nanochord/h-energosmart/docs/hajdu_energo_smart.pptx

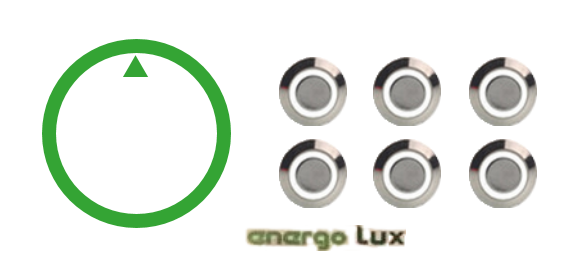
[picture p4: figure]

VCC

WCU
Power Supply
+5V
+12V

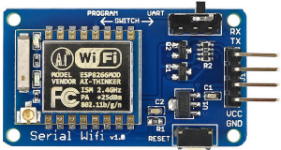
[picture p5: figure]

WiFi

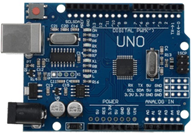
[picture p6: figure]

VCC

UART

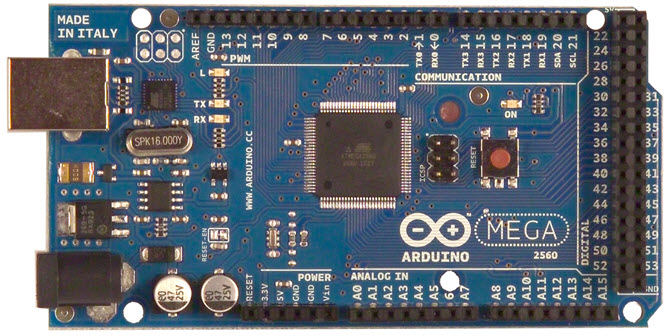
[picture p7: figure]
Képtalálat a következ&odblac;re: „arduino mega2560”

Digital Input

DOUT LED Control

I2C

UART

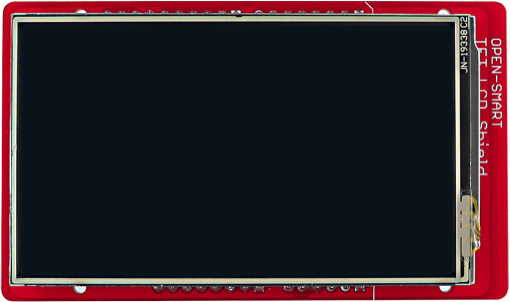
[picture p8: figure]

8-BIT BUS

HAJDU
Electromechanical Unit

Relay Contacts

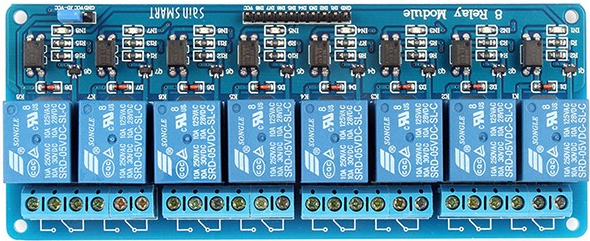
[picture p9: figure]

DOUT
Relay control

DOUT Relay control

TFT LCD

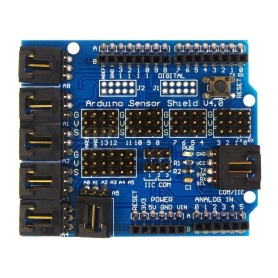
[picture p10: figure]
Képtalálat a következ&odblac;re: „arduino sensor shield”

Level control
and protection
unit

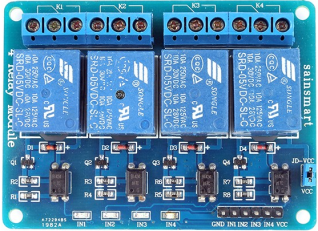
[picture p11: figure]

Digital & Analog Input

MP3

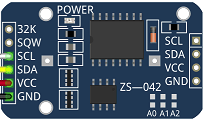
[picture p12: figure]

RTC

HAJDU Energo Smart
Block diagram
2017.6.1

## Slide 2

WMU
Motors
Radiators
Actuators
Sensors

HAJDU Energo Smart
Wiring Scheme
2017.6.1

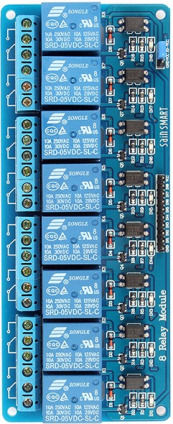
[picture p13: figure]

WCU
MEGA 2560
WIFI (ESP8266)
RTC (DS3231)
MP3 DFPlayer

+VCC
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
+VCC
B9
B10
B11
B12
GND

JP10

X4

SCOM
T36
T55
T85
WL1
WL2
WL3

X3

JP11

ROT1
ROT2
ROT3
PB1
PB2
PB3
PB4
LED1
LED2
LED3
LED4
GND

JP8

+M5V
PULSE
GND

FLOW
RATE

JP14

+12V
+5V
DOOR_LOCK
T124FUSE
CURR_OUT
MAIN SW
GND

JP13

JP9

SDA
SCL
+12V
GND

POWER BOARD
Power Supply +5V, +12V
U-Detectors 1, 2
Main SW Relay 1, 2
Current Sensor

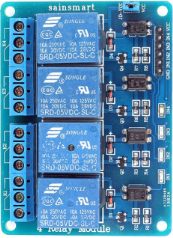
[picture p14: figure]

DISPLAY
Arduino UNO driven

+5V
GND

JP5

+5V
GND

JP6

+12V
+5V
DOOR_LOCK
T124FUSE
CURR_OUT
MAIN SW
GND

JP4

JP3

DOOR_LOCK
T124FUSE

AC OUT

KEYPAD
Buttons and LEDs

U-DETECTOR LINES

JP2

AC IN

JP1

WMU POWER LINE
~240VAC

~240VAC
