nanochord/h-energosmart/docs/10-allasu_10-polusu_valasztokapcs.jpg

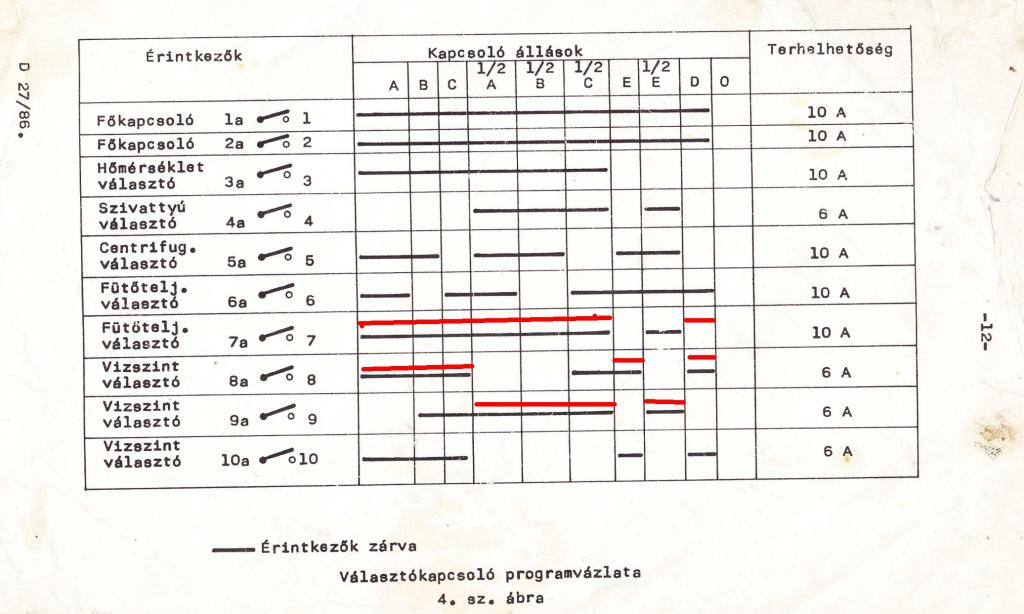
docs/10-allasu_10-polusu_valasztokapcs.jpg
