nanochord/h-energosmart/docs/aramutas_rajz_en_thermal.jpg

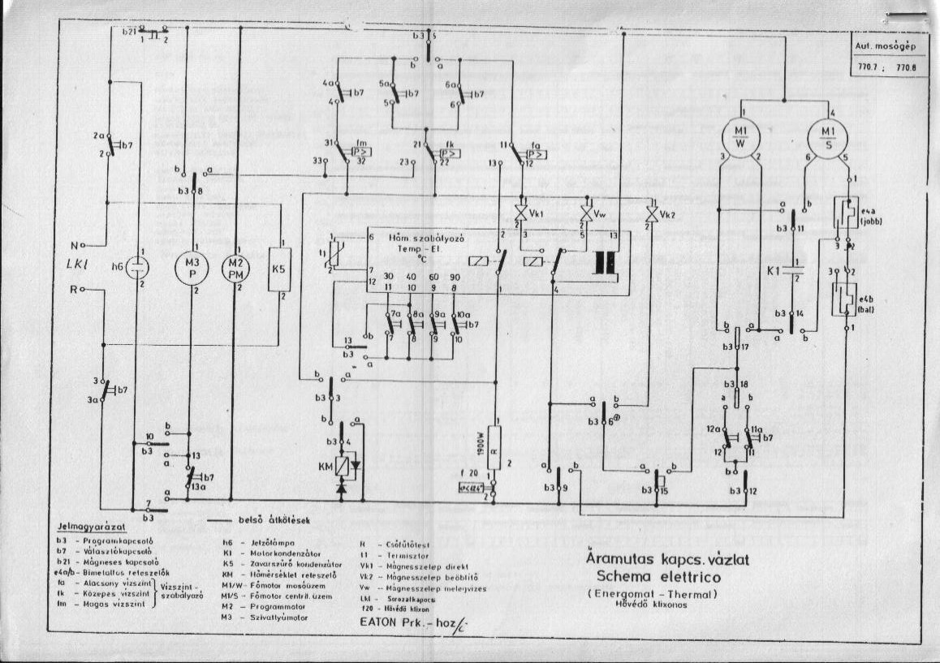
docs/aramutas_rajz_en_thermal.jpg
