nanochord/h-energosmart/docs/en-750-1.jpg

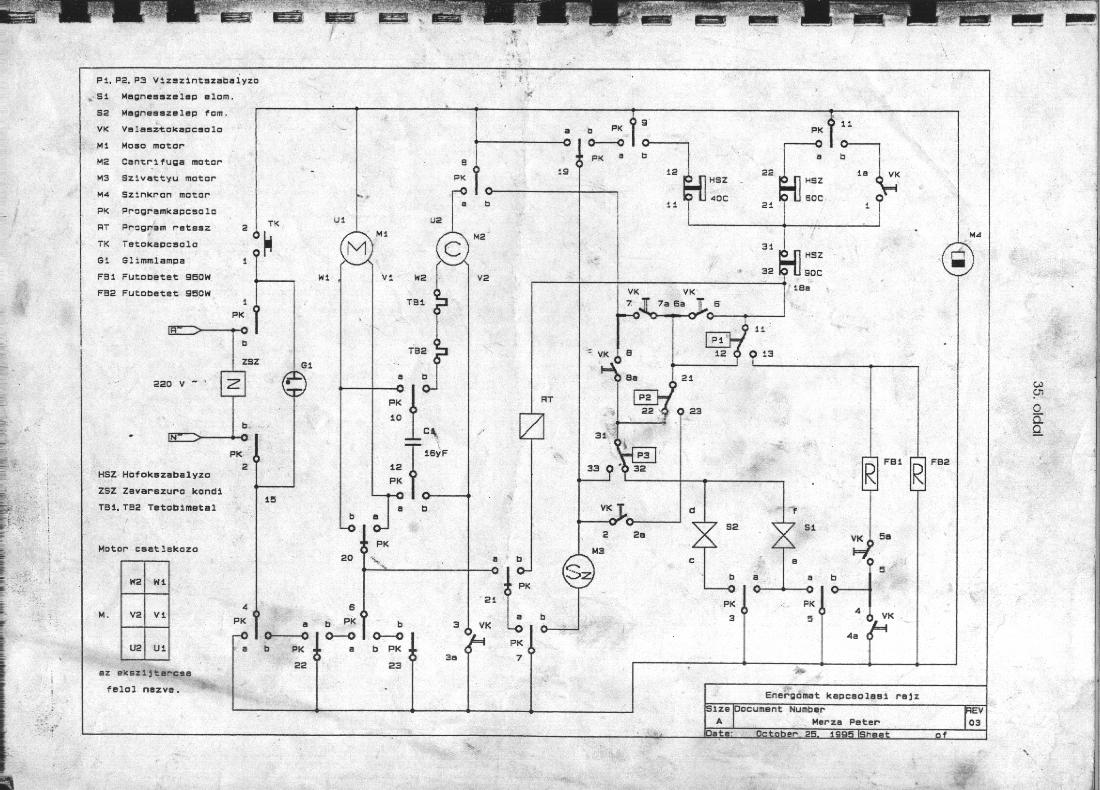
docs/en-750-1.jpg
