nanochord/h-energosmart/docs/en_750_4.jpg

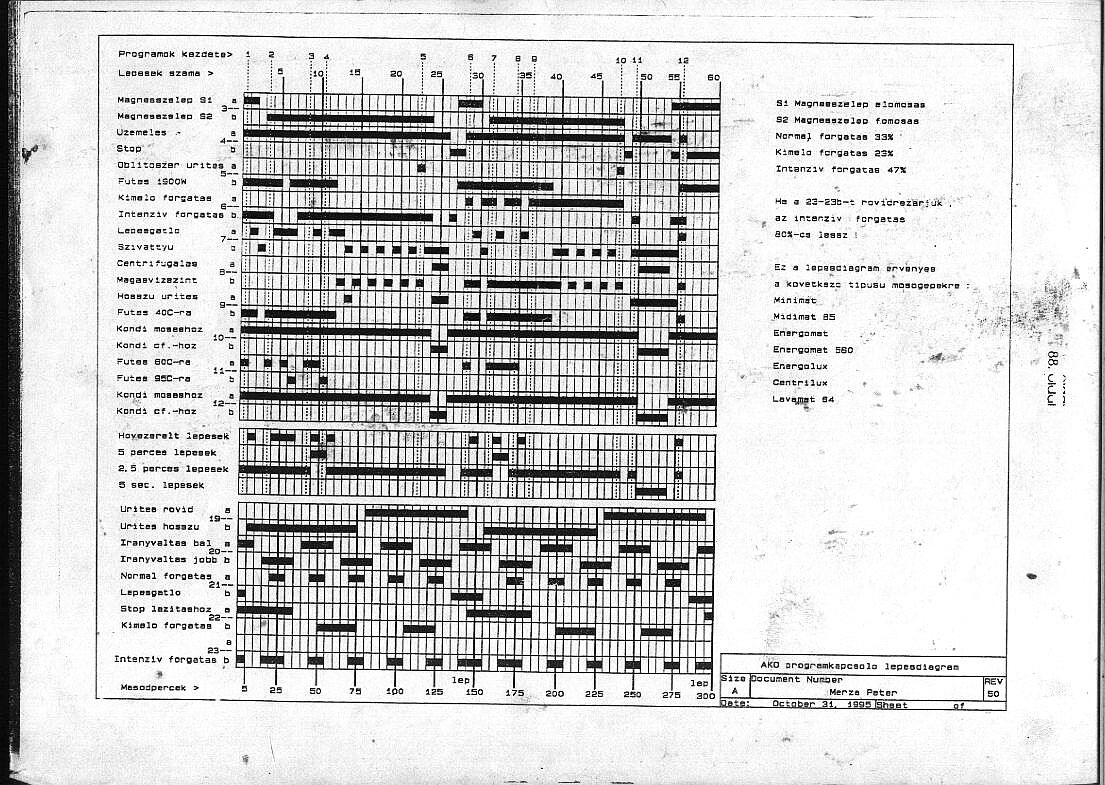
docs/en_750_4.jpg
