nanochord/h-energosmart/docs/tmp32.jpg

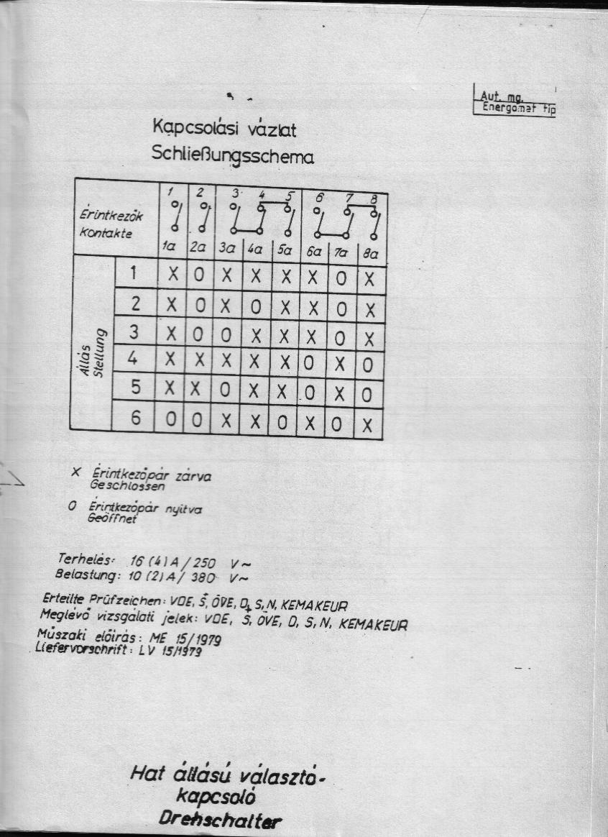
docs/tmp32.jpg
