nanochord/h-energosmart/docs/tmp33.jpg

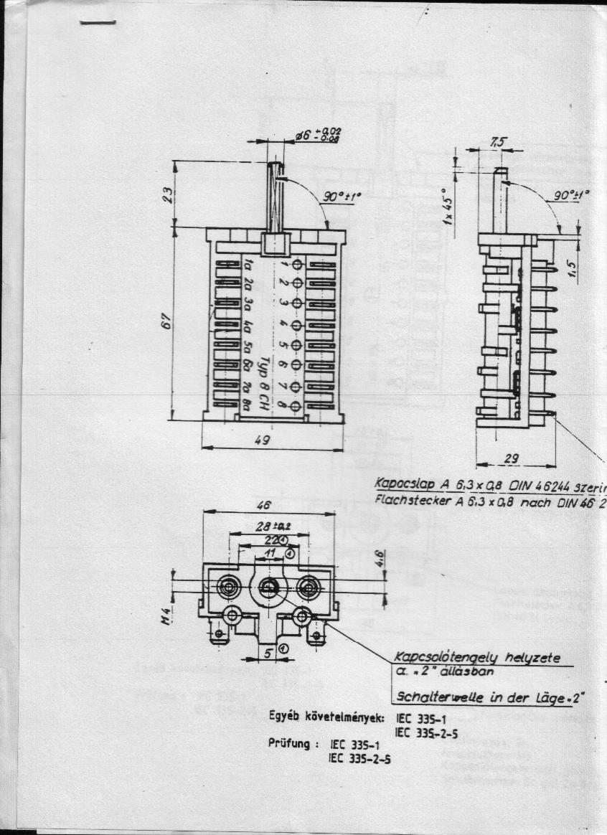
docs/tmp33.jpg
