nanochord/h-energosmart/docs/tmp34.jpg

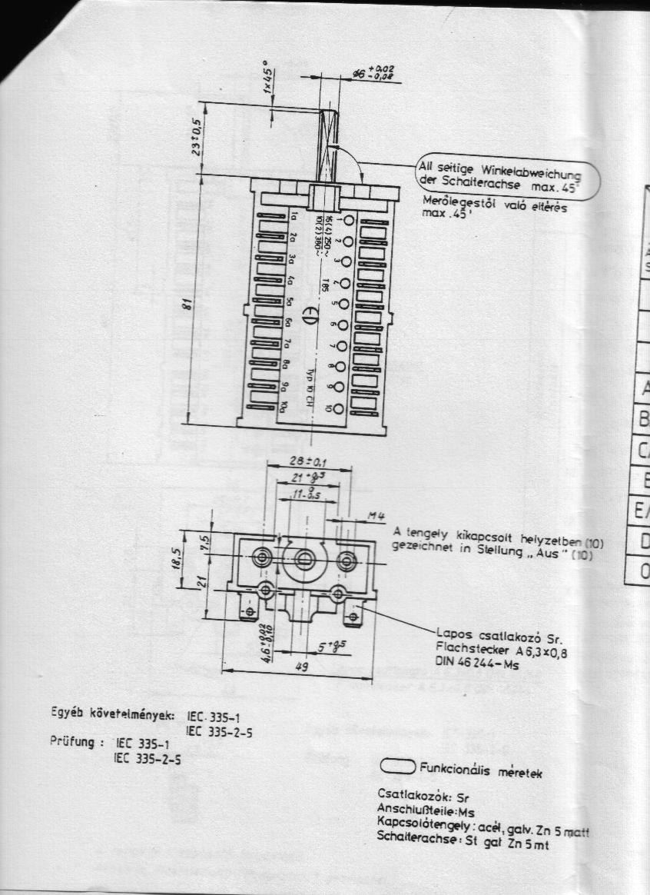
docs/tmp34.jpg
