nanochord/h-energosmart/docs/tmp35.jpg

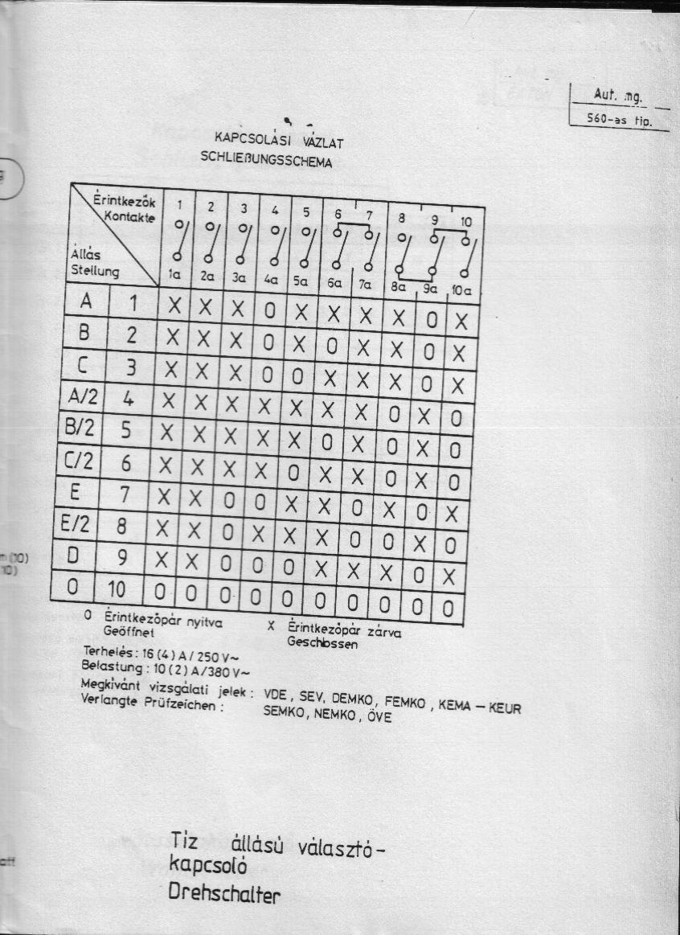
docs/tmp35.jpg
