nanochord/h-energosmart/docs/tmp36.jpg

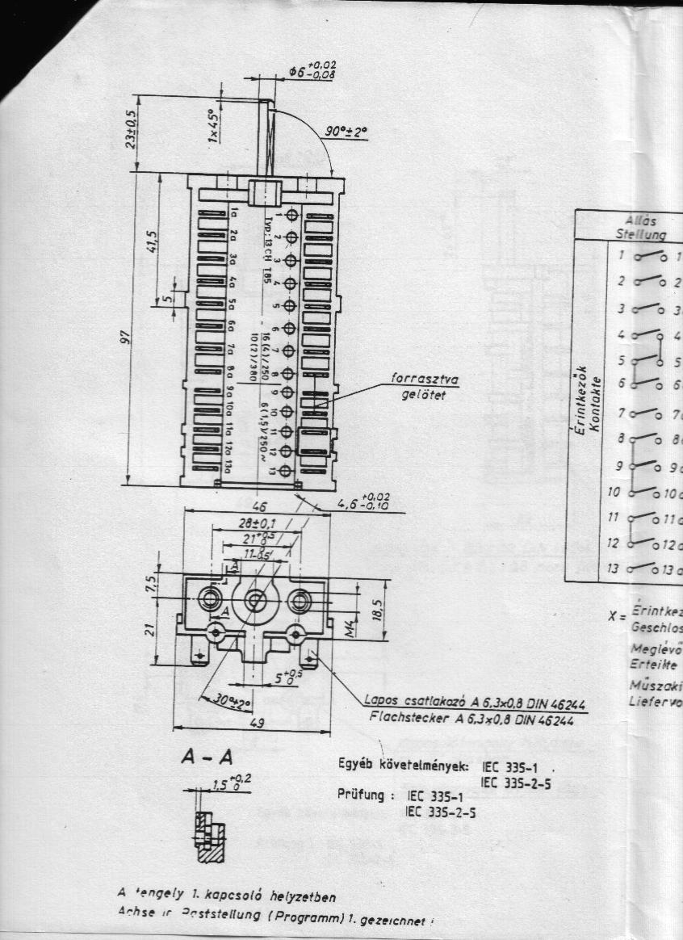
docs/tmp36.jpg
