nanochord/h-energosmart/docs/tmp37.jpg

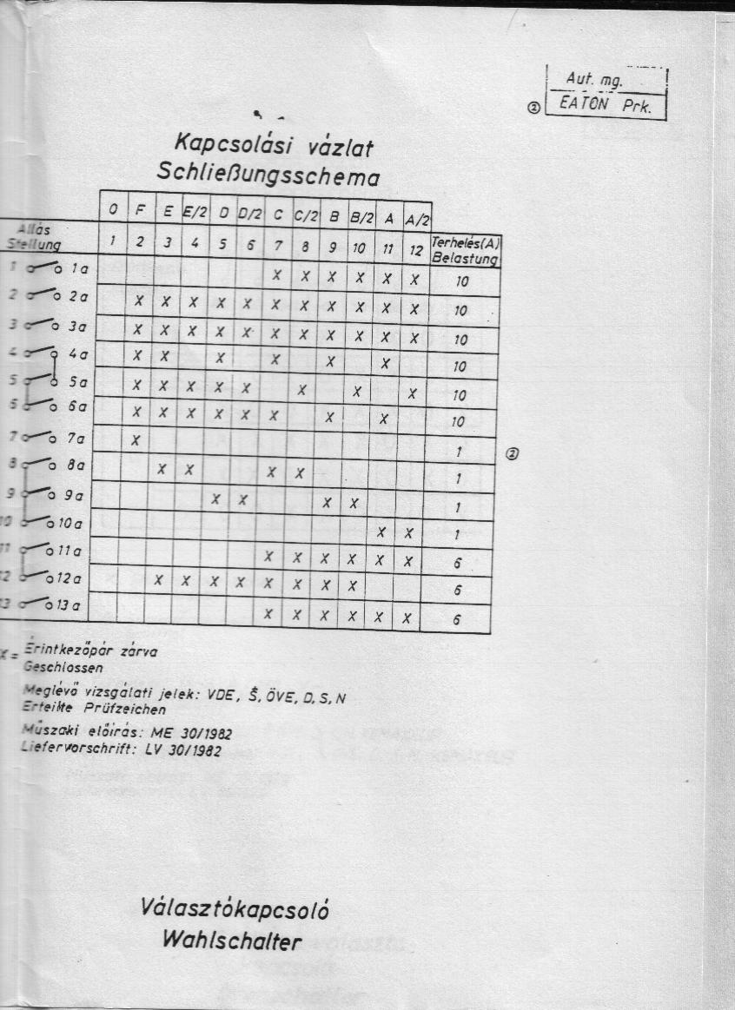
docs/tmp37.jpg
