nanochord/h-energosmart/docs/tmp39.jpg

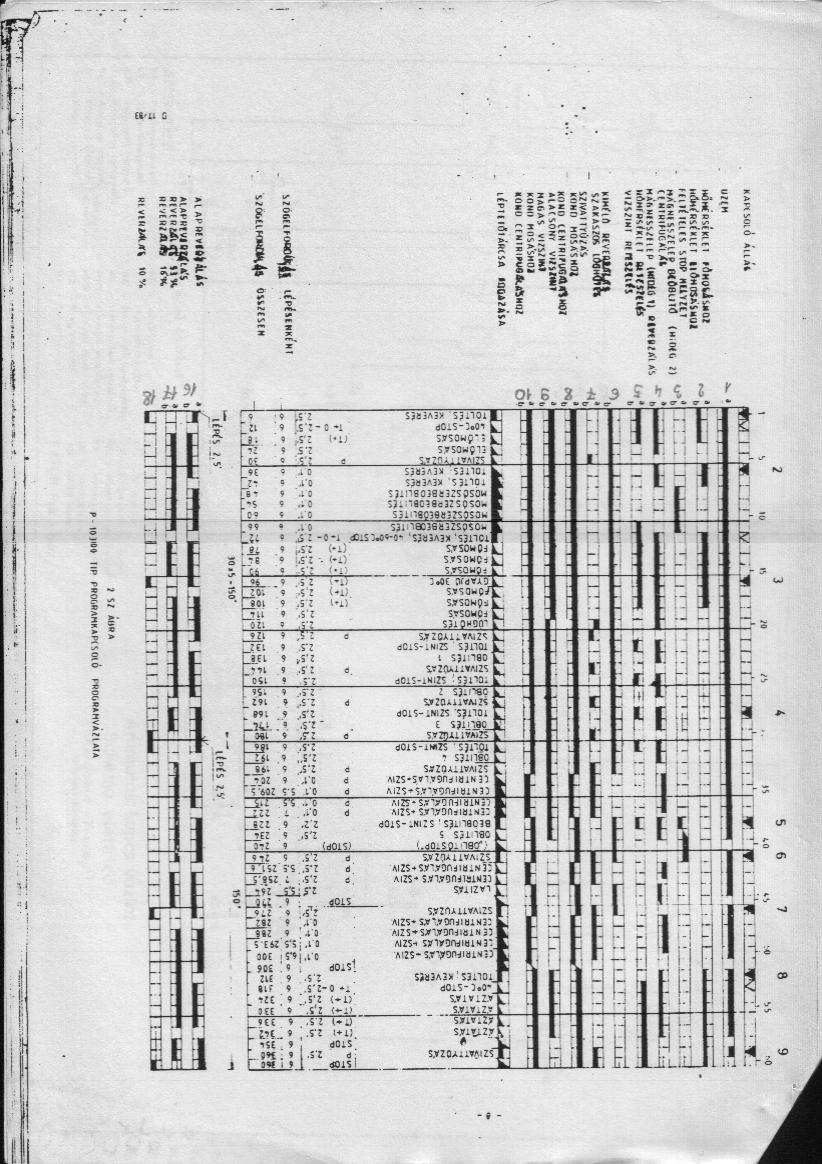
docs/tmp39.jpg
