nanochord/h-energosmart/docs/tmp40.jpg

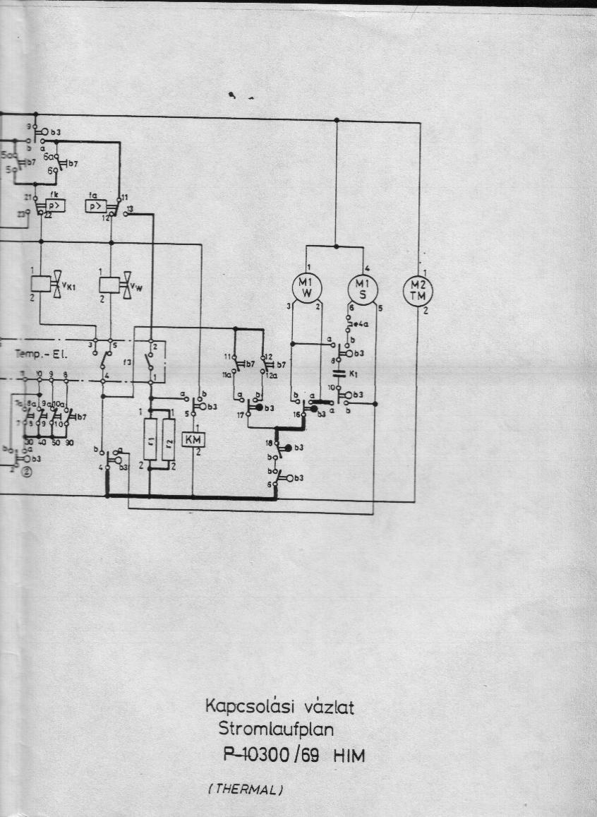
docs/tmp40.jpg
