nanochord/h-energosmart/docs/tmp41.jpg

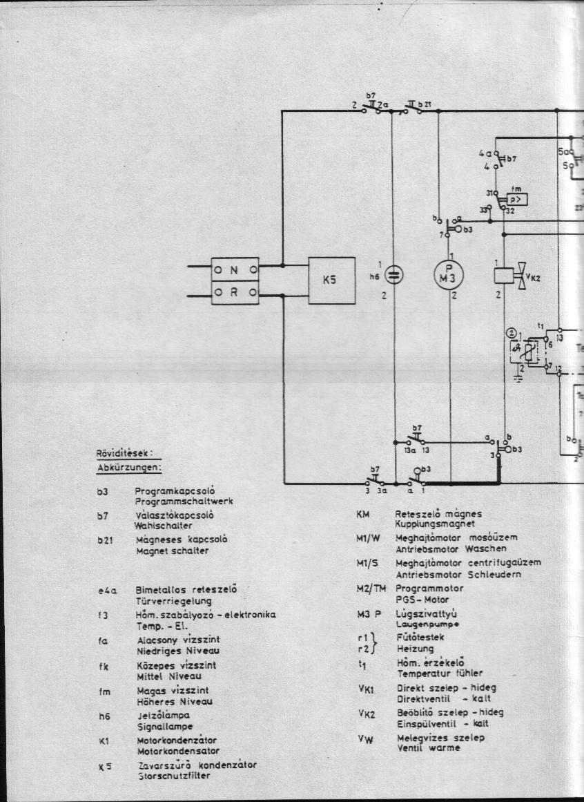
docs/tmp41.jpg
