nanochord/h-energosmart/docs/tmp42.jpg

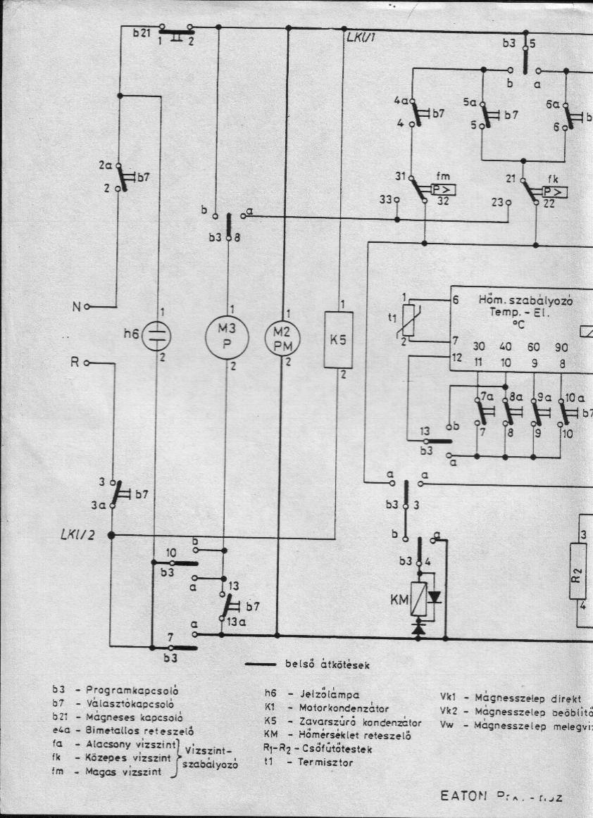
docs/tmp42.jpg
