nanochord/h-energosmart/docs/tmp43.jpg

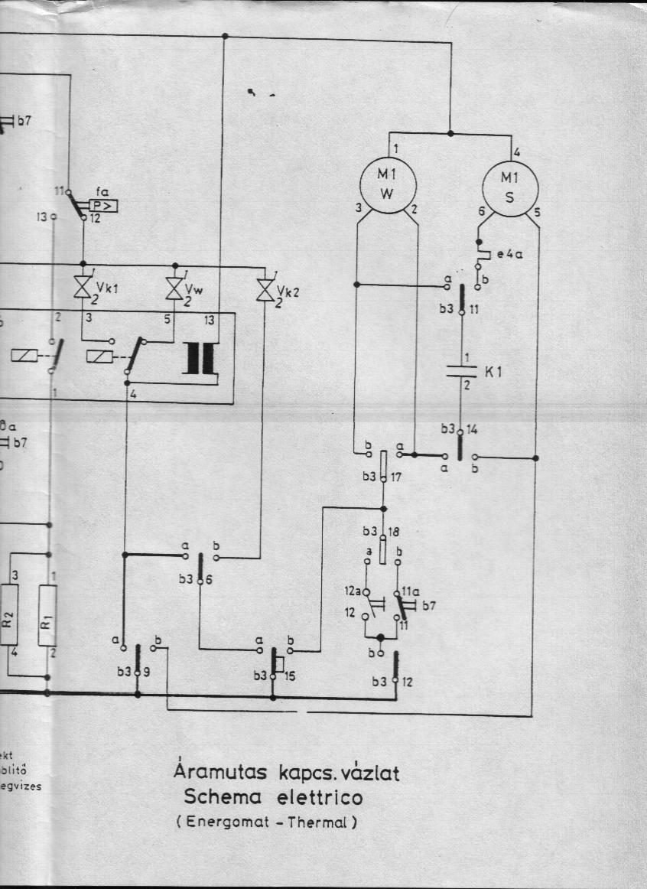
docs/tmp43.jpg
