nanochord/h-energosmart/images/hajdu-1-1.jpg

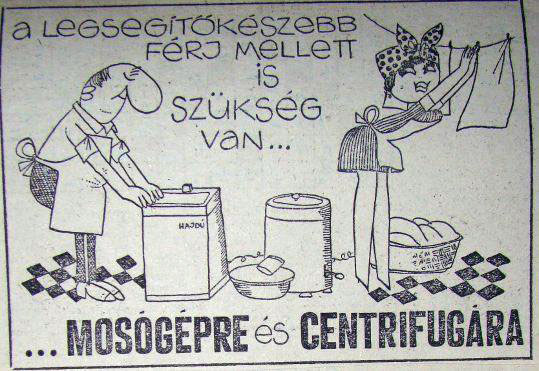
images/hajdu-1-1.jpg
