nanochord/h-energosmart/docs/parts_list.txt

Order
-----

CT1	ACS712 20A Current Sensor Module		1 pcs	  410,-
FRS1	Flow Rate Sensor				1 pcs	1 218-,
VD1..3	Power supply Driver Electronic Transformer	3 pcs	  317,-

ESP8266-Serial-Wifi-Transceiver- (ESP-07)		1 pcs	1 628,-
ZS042 DS3231 AT24C32 IIC module precision (RTC)		1 pcs	  410,-
MP3 DFPlayer						1 pcs	  755,-

http://www.ebay.com/itm/New-5A-20A-30A-Range-Current-Sensor-Module-ACS712-For-Arduino-Raspberry-Pi-UNO-/112275500486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

http://www.ebay.com/itm/1PC-1-30L-min-1-75MPa-Water-Flow-Sensor-Flowmeter-Water-Flow-Rate-Sensor-Black-/201411234904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

http://www.ebay.com/itm/AC-85V-265V-to-DC-9-12V-LED-Electronic-Transformer-Power-Supply-Driver-3X1W-Gift/111816323915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

http://www.ebay.com/itm/ESP8266-Serial-Wifi-Transceiver-Board-Module-for-Arduino-ESP-07-V1-0-/162082552620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

http://www.ebay.com/itm/ZS042-DS3231-AT24C32-IIC-module-precision-Real-time-clock-quare-memory-Arduino-/221549752451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

http://www.ebay.com/itm/TF-Card-U-Disk-Mini-MP3-Player-Audio-Voice-Module-Board-For-Arduino-DFPlayer-/332035458402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

-----------------------------

Power supply		12V 3A				1 pcs	1 530,-
DC Relay 12V 16A					1 pcs	  490,-

http://www.ebay.com/itm/110V-220V-to-DC5V-12V-24V-48V-Switch-Power-Supply-Driver-Adapter-LED-Strip-Light/142350726194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

http://www.ebay.com/itm/1PCS-SMIH-12VDC-SL-C-DC-12V-16A-250VAC-Power-Relay-NEW-CK-/191941275550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
