nanochord/h-energosmart/docs/hajdu_energo_smart.pdf

# WCU Power Supply

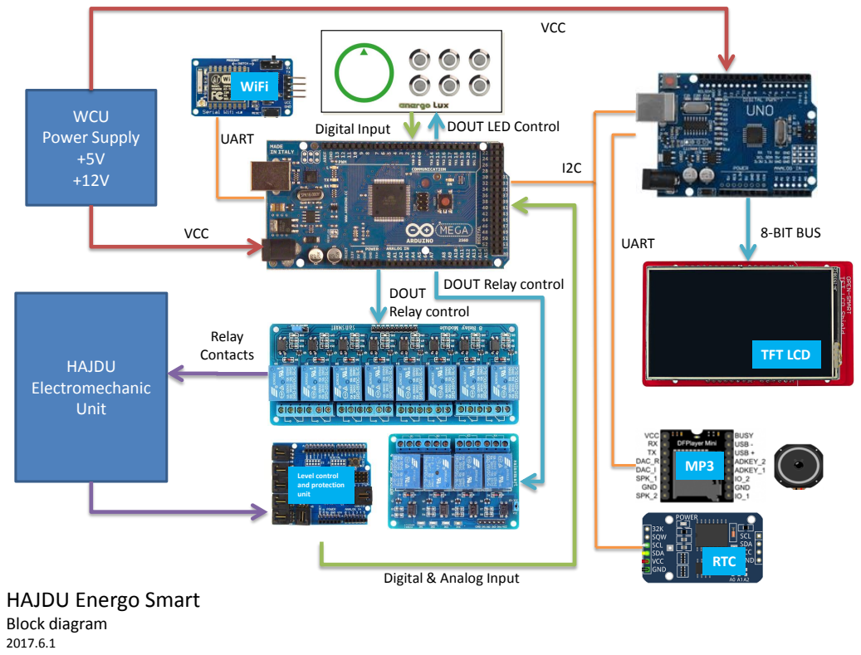
[picture p31: page 1]
HAJDU Electromechanic Unit; UART; 8-BIT BUS; VCC; Relay Contacts; Digital Input; RTC; TFT LCD; Level control and protection unit; WiFi

DOUT LED Control

DOUT Relay control DOUT
Relay control

Digital & Analog Input

HAJDU Energo Smart
Block diagram

## WCU

# HAJDU Energo Smart

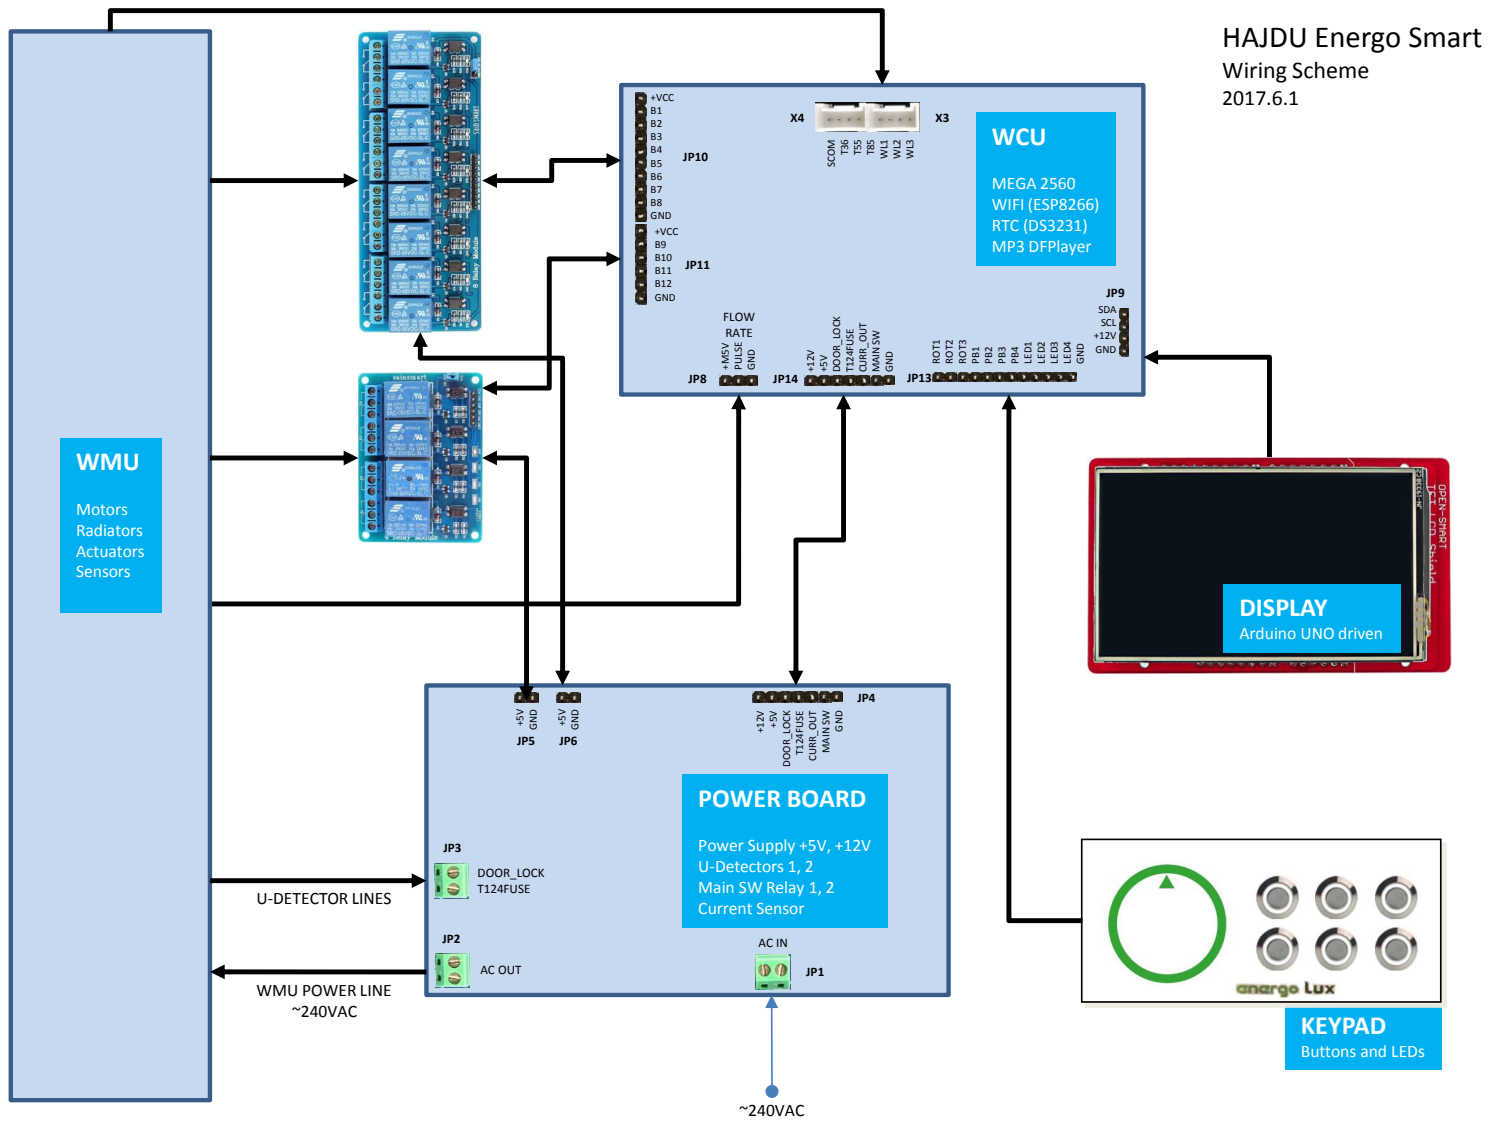
[picture p32: page 2]
