nanochord/h-energosmart/src/sch/hes_keypad.sch

## EAGLE design src/sch/hes_keypad.sch (2024-10-10)

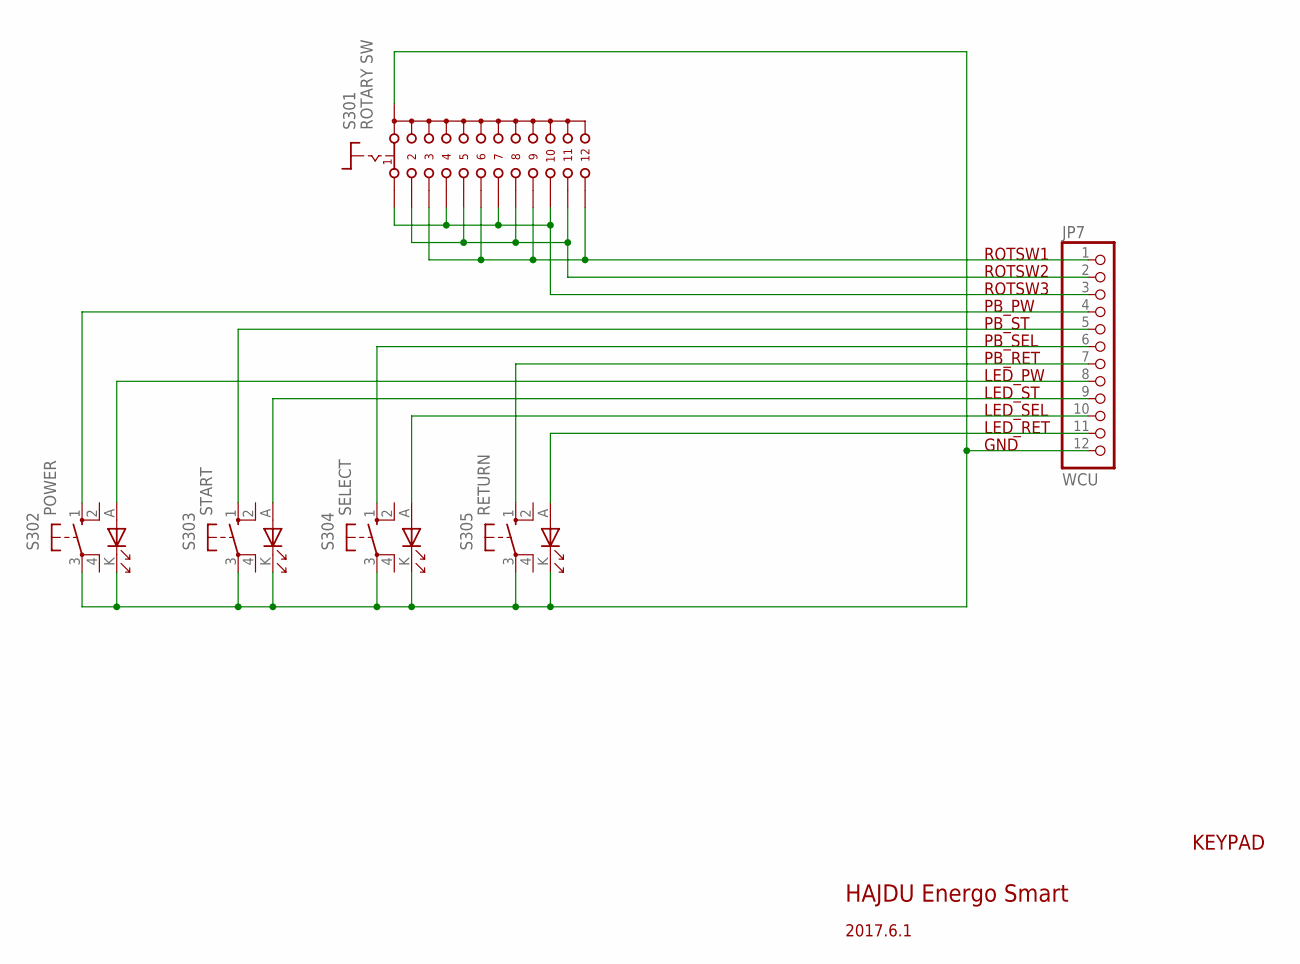
[picture p33: schematic hes_keypad.sch]

Parts:
JP7: WCU; 1X12
S301: ROTARY SW; ELMA-01-1X12
S302: POWER; B3F/40L3
S303: START; B3F/40L3
S304: SELECT; B3F/40L3
S305: RETURN; B3F/40L3

Connections:
unnamed: JP7.12, S301.A, S302.3, S302.K (C), S303.3, S303.K (C), S304.3, S304.K (C), S305.3, S305.K (C)
unnamed: JP7.3, S301.1, S301.4, S301.7, S301.10
unnamed: JP7.11, S305.A
unnamed: JP7.7, S305.1 (S)
unnamed: JP7.6, S304.1 (S)
unnamed: JP7.5, S303.1 (S)
unnamed: JP7.4, S302.1 (S)
unnamed: JP7.2, S301.2, S301.5, S301.8, S301.11
unnamed: JP7.1, S301.3, S301.6, S301.9, S301.12

Notes on the sheet:
HAJDU Energo Smart
2017.6.1
KEYPAD
GND
ROTSW1
ROTSW2
ROTSW3
PB_PW
PB_ST
PB_SEL
PB_RET
LED_PW
LED_ST
LED_SEL
LED_RET
