nanochord/h-energosmart/src/sch/hes_power_board.sch

## EAGLE design src/sch/hes_power_board.sch (2024-10-10)

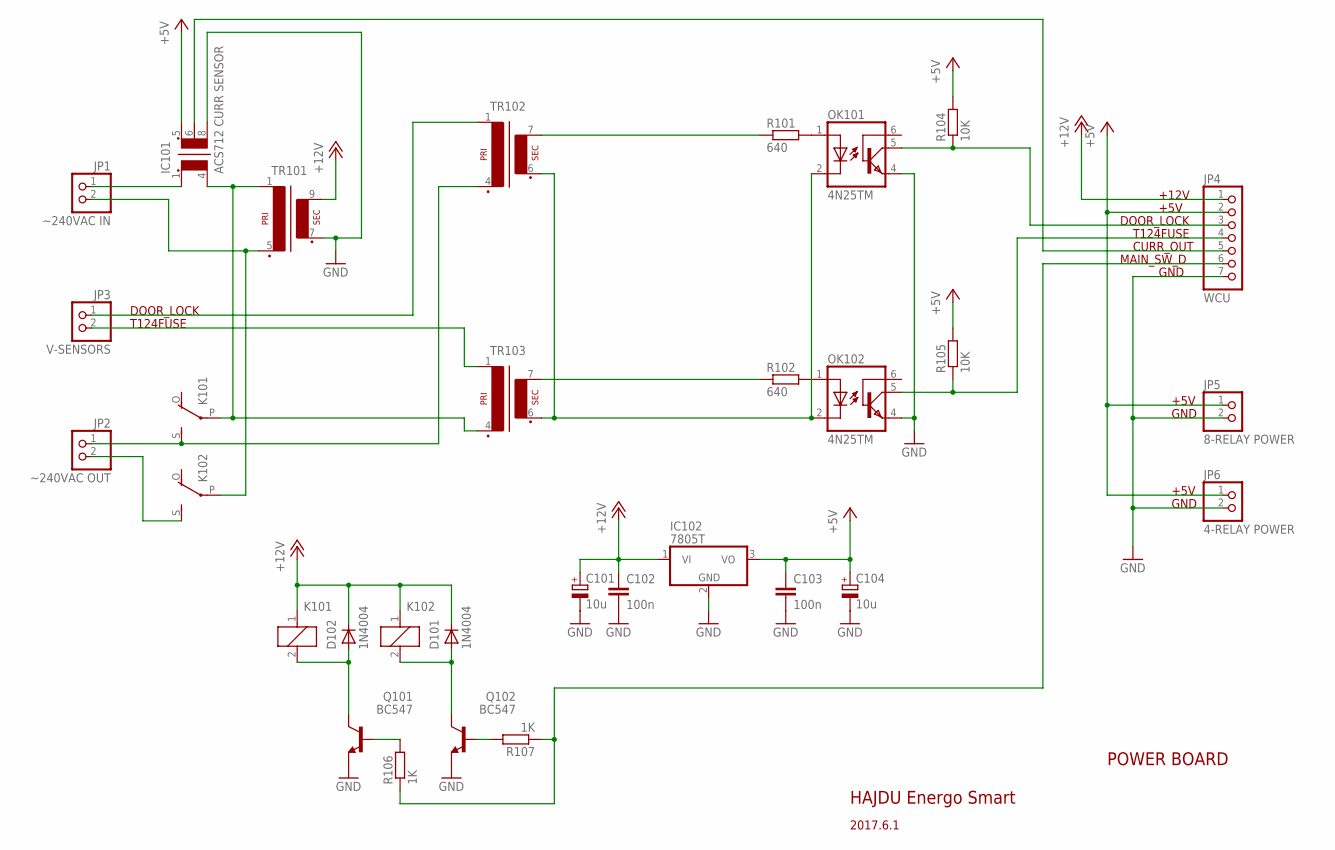
[picture p34: schematic hes_power_board.sch]

Parts:
C101, C104: 10u; 085CS_1AR
C102, C103: 100n; XC10B5
D101, D102: 1N4004; SMA-DO214AC
IC101: ACS712 CURR SENSOR; CTX02-14659
IC102: 7805T; TO220H
JP1: ~240VAC IN; 1X02
JP2: ~240VAC OUT; 1X02
JP3: V-SENSORS; 1X02
JP4: WCU; 1X07
JP5: 8-RELAY POWER; 1X02
JP6: 4-RELAY POWER; 1X02
K101, K102: E3206S
OK101, OK102: 4N25TM; DIL6-04
Q101, Q102: BC547; TO92
R101, R102: 640; 0204/5
R104, R105: 10K; 0204/5
R106, R107: 1K; 0204/5
TR101: EI30-1
TR102, TR103: EE20-1

Connections:
+5V: C103.1, C104.+, IC101.5, IC102.3 (VO), JP4.2, JP5.1, JP6.1, R104.2, R105.2
+12V: C101.+, C102.1, D101.K (C), D102.K (C), IC102.1 (VI), JP4.1, K101.1, K102.1, TR101.9 (S4)
GND: C101.-, C102.2, C103.2, C104.-, IC101.8 (3), IC102.2 (GND), JP5.2, JP6.2, OK101.4 (EMI), OK102.4 (EMI), Q101.1 (E), Q102.1 (E), TR101.7 (S3)
unnamed: OK101.1 (A), R101.2
unnamed: JP4.3, OK101.5 (COL), R104.1
unnamed: JP4.4, OK102.5 (COL), R105.1
unnamed: R101.1, TR102.7 (S4)
unnamed: JP2.2, K102.S
unnamed: OK101.2 (C), OK102.2 (C), TR102.6 (S3), TR103.6 (S3), TR103.7 (S4)
unnamed: K102.P, TR101.5 (P2)
unnamed: D101.A, K102.2, Q102.3 (C)
unnamed: D102.A, K101.2, Q101.3 (C)
unnamed: Q101.2 (B), R106.2
unnamed: OK102.1 (A), R102.2
unnamed: IC101.6 (4), JP4.5
unnamed: Q102.2 (B), R107.2
unnamed: IC101.4 (2), K101.P, TR101.1, TR103.4 (P2)
unnamed: JP4.6, R106.1, R107.1

Notes on the sheet:
HAJDU Energo Smart
POWER BOARD
2017.6.1
DOOR_LOCK
T124FUSE
+12V
+5V
CURR_OUT
MAIN_SW_D
GND
