nanochord/h-energosmart/src/sch/hes_wcu.sch

## EAGLE design src/sch/hes_wcu.sch (2024-10-10)

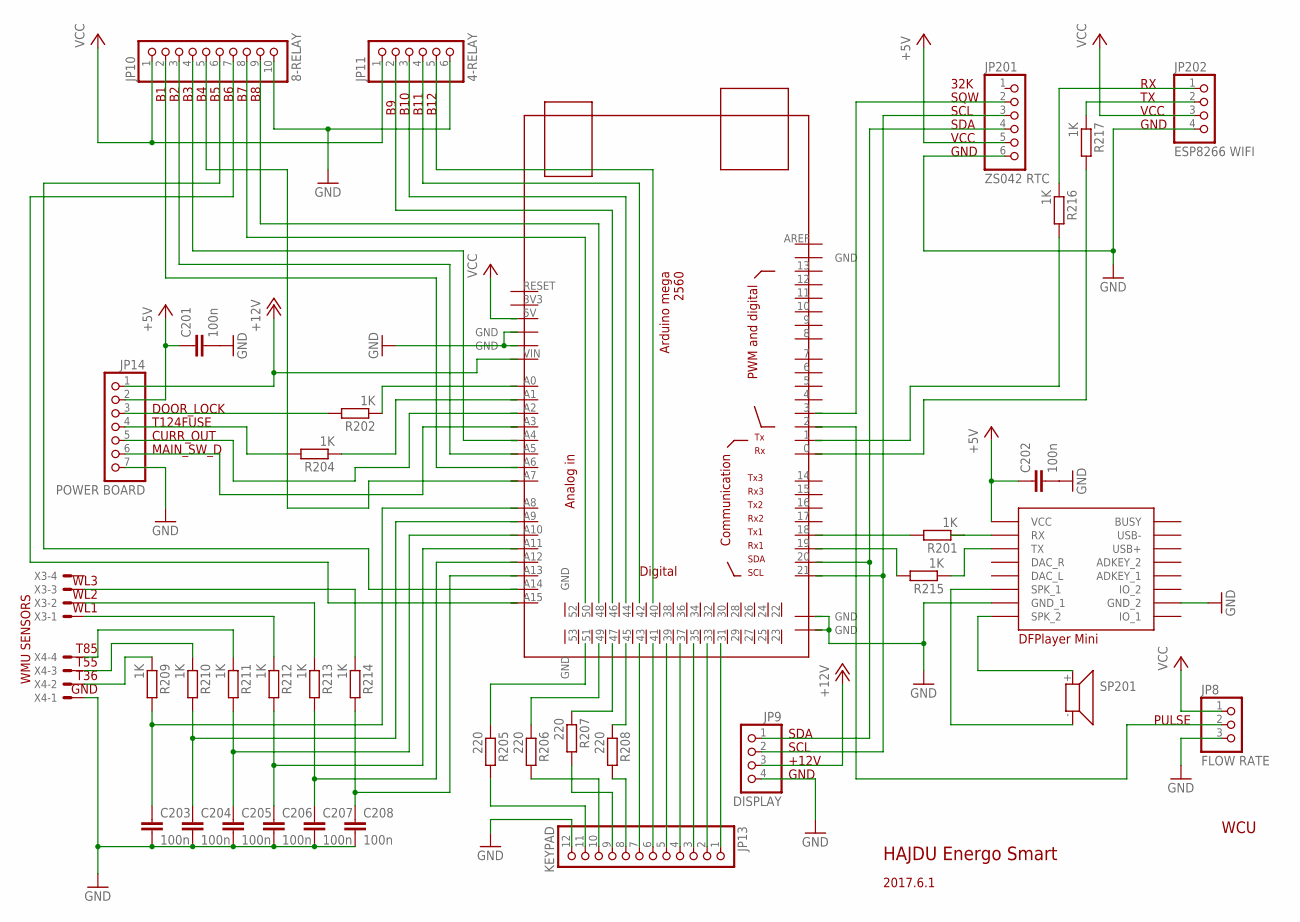
[picture p35: schematic hes_wcu.sch]

Parts:
C201, C202, C203, C204, C205, C206, C207, C208: 100n; C025-024X044
JP8: FLOW RATE; 1X03
JP9: DISPLAY; 1X04
JP10: 8-RELAY; 1X10
JP11: 4-RELAY; 1X06
JP13: KEYPAD; 1X12
JP14: POWER BOARD; 1X07
JP201: ZS042 RTC; 1X06
JP202: ESP8266 WIFI; 1X04
R201, R202, R204, R209, R210, R211, R212, R213, R214, R215, R216, R217: 1K; 0204/5
R205, R206, R207, R208: 220; 0204/5
SP201: SMS-1308MS-2-R
U$1: MEGA_DEVICE; MEGABOX
U$2: DFPLAYER
X3, X4: 53047-04

Connections:
+5V: C201.1, C202.1, JP14.2, JP201.5, U$2.VCC
+12V: JP9.3, JP14.1
GND: C201.2, C202.2, C203.2, C204.2, C205.2, C206.2, C207.2, C208.2, JP8.3, JP9.4, JP10.10, JP11.6, JP13.12, JP14.7, JP201.6, JP202.4, U$2.GND_1, U$2.GND_2, X4.1
unnamed: SP201.+ (1), U$2.SPK2 (SPK_2)
unnamed: R209.1, X4.2
unnamed: SP201.- (2), U$2.SPK1 (SPK_1)
unnamed: JP14.3, R202.2
unnamed: R201.1, U$2.RX
unnamed: JP14.4, R204.2
unnamed: JP13.11, R205.2
unnamed: JP13.10, R206.2
unnamed: JP13.9, R207.2
unnamed: JP13.8, R208.2
unnamed: R210.1, X4.3
unnamed: C203.1, R209.2
unnamed: C204.1, R210.2
unnamed: JP9.1, JP201.4
unnamed: JP9.2, JP201.3
unnamed: C205.1, R211.2
unnamed: C206.1, R212.2
unnamed: C207.1, R213.2
unnamed: C208.1, R214.2
unnamed: R211.1, X4.4
unnamed: R212.1, X3.1
unnamed: R213.1, X3.2
unnamed: R214.1, X3.3
unnamed: R215.1, U$2.TX
unnamed: JP10.1, JP11.1
unnamed: JP202.2, R217.1
unnamed: JP202.1, R216.1
VCC: JP8.1, JP202.3

Notes on the sheet:
HAJDU Energo Smart
WCU
2017.6.1
DOOR_LOCK
T124FUSE
CURR_OUT
MAIN_SW_D
PULSE
B10
B11
B12
GND
T36
T55
T85
WL1
WL2
WL3
SCL
SDA
SQW
32K
VCC
DFPlayer Mini
WMU SENSORS
+12V
