nanochord/h-energosmart/src/sch/hes_wmu.sch

## EAGLE design src/sch/hes_wmu.sch (2024-10-10)

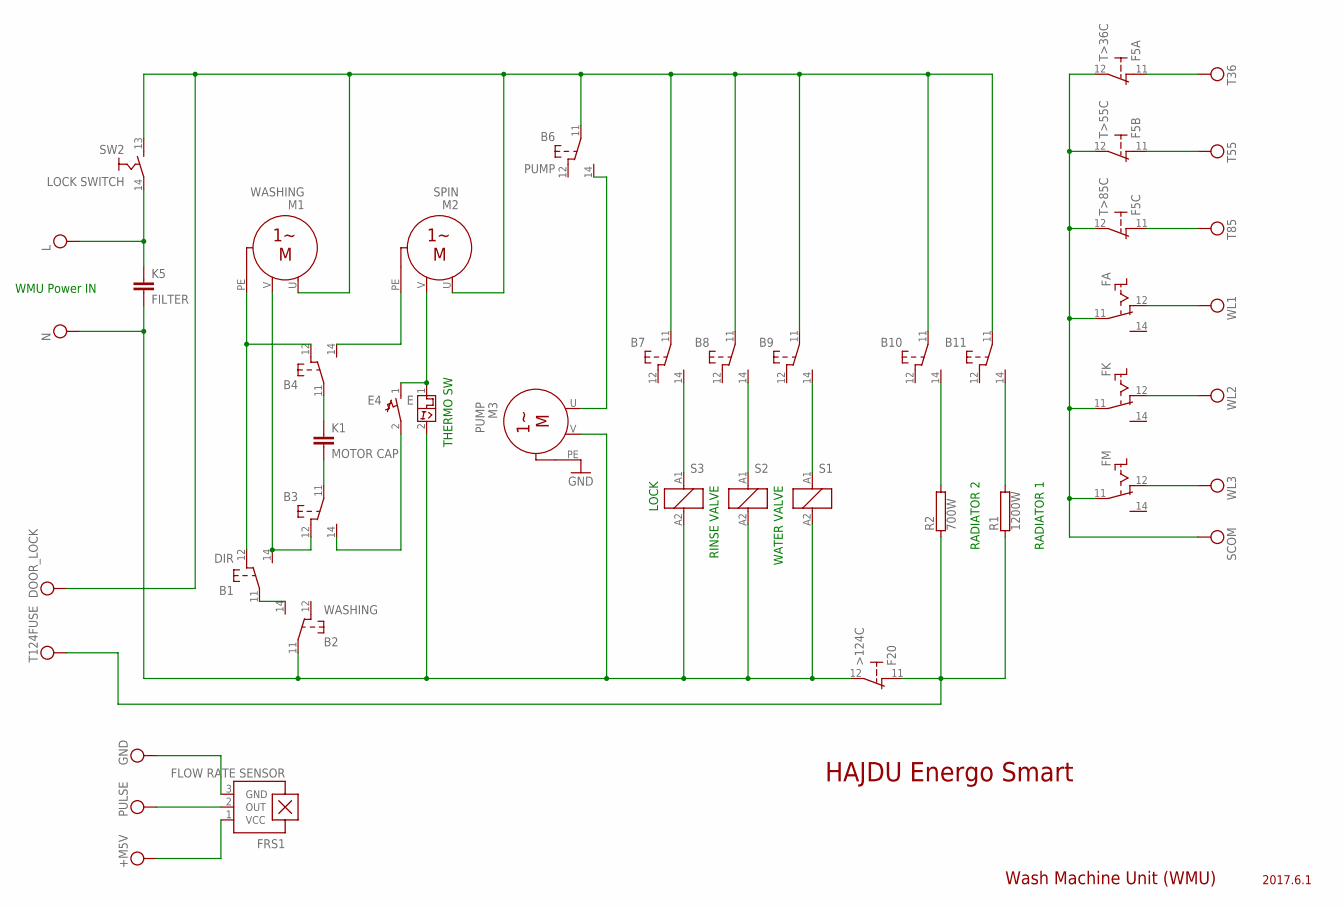
[picture p36: schematic hes_wmu.sch]

Parts:
B1: DIR; DRUCK-WECHSELSCHALTER
B2: WASHING; DRUCK-WECHSELSCHALTER
B3, B4, B7, B8, B9, B10, B11: DRUCK-WECHSELSCHALTER
B6: PUMP; DRUCK-WECHSELSCHALTER
E: MOTORSCHUTZSCHALTER_1-POL_THERM_MAG_AUSLOESUNG_AL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; MOTORSCHUTZSCHALTER_1-POL_THERM_MAG_AUSLOESUNG
E4: MOTORSCHUTZSCHALTER_1-POL_THERM_AUSLOESUNG
F5A: T>36C; SCHALTER_OEFFNER
F5B: T>55C; SCHALTER_OEFFNER
F5C: T>85C; SCHALTER_OEFFNER
F20: >124C; SCHALTER_OEFFNER
FA: DREH-WECHSELSCHALTER
FK: DREH-WECHSELSCHALTER
FM: DREH-WECHSELSCHALTER
FRS1: FLOW RATE SENSOR; SOT23-W
K1: MOTOR CAP; C37.5B20
K5: FILTER; C375-203X418
M1: WASHING; MOTOR_1-PHASEN
M2: SPIN; MOTOR_1-PHASEN
M3: PUMP; MOTOR_1-PHASEN
R1: 1200W; AC01
R2: 700W; AC01
S1: Mágnesszelep; ZN5
S2: Beöblítő; ZN5
S3: Lock; ZN5
SW2: LOCK SWITCH; SCHLIESSER_RASTSCHALTER

Connections:
GND: M3.PE
unnamed: B4.14, M2.PE
unnamed: B1.12, B4.12, M1.PE
unnamed: B4.11, K1.1
unnamed: B3.11, K1.2
unnamed: B1.14, B3.12, M1.V
unnamed: B1.11, B2.14
unnamed: B10.14, R2.2
unnamed: E.1, E4.1, M2.V
unnamed: B3.14, E4.2
unnamed: B6.14, M3.U
unnamed: B11.14, R1.2
unnamed: B7.14, S3.A1 (1)
unnamed: B8.14, S2.A1 (1)
unnamed: B9.14, S1.A1 (1)
VCC: B2.11, B6.11, B7.11, B8.11, B9.11, B10.11, B11.11, E.2, F5A.11 (1), F5A.12 (2), F5B.11 (1), F5B.12 (2), F5C.11 (1), F5C.12 (2), F20.11 (1), F20.12 (2), FA.11, FA.12, FK.11, FK.12, FM.11, FM.12, FRS1.1 (VCC), FRS1.2 (OUT), FRS1.3 (GND), K5.1, K5.2, M1.U, M2.U, M3.V, R1.1, R2.1, S1.A2 (2), S2.A2 (2), S3.A2 (2), SW2.13 (3), SW2.14 (4)

Notes on the sheet:
THERMO SW
LOCK
RINSE VALVE
WATER VALVE
RADIATOR 2
RADIATOR 1
WMU Power IN
HAJDU Energo Smart
Wash Machine Unit (WMU)
2017.6.1
